csresearchlabsindia/AI-Site-Agent/(commit log)

2026-09-14 README: chassis design section
2026-09-16 asa-journal: web view, changelog tab, threading and shutdown fixes
2026-09-18 LED ATTENTION state for speaker offline; teleop drive panel
2026-10-01 E-stop detection on A0, pack voltage API and dashboard power card; left drive fixes
    [sketch.ino]
2026-10-01 Redesigned dashboard: status hero, tabs, power chart; add asa-powerlog service
2026-10-04 slam: OAK-D probe, VIO and RTAB-Map stationary tests, calibration backup
2026-10-04 docs: on-board SLAM — pipeline drawing ASA-SW-02, Map tab, first map
